devjamescollier/Dual-Channel_Embedded_Power_Supply_Board/Manufacturing/Assembly/BOM.csv

Comment | Designator | Footprint | LCSC Part # | MPN | Quantity
4.7uF | C1,C2,C10,C11 | C_0805_2012Metric | C1779 | CL21A475KAQNNNE | 4
100nF | C3 | C_0603_1608Metric | C14663 | CC0603KRX7R9BB104 | 1
10nF | C4 | C_0402_1005Metric | C15195 | CL05B103KB5NNNC | 1
100nF | C5,C12,C14 | C_0201_0603Metric | C76939 | GRM033R61E104KE14D | 3
47uF | C6,C7 | C_1206_3216Metric | C96123 | CL31A476MPHNNNE | 2
1nF | C8 | C_0402_1005Metric | C1523 | 0402B102K500NT | 1
47pF | C9 | C_0402_1005Metric | C1567 | 0402CG470J500NT | 1
10nF | C13 | C_0201_0603Metric | C85930 | GRM033R71E103KE14D | 1
47uF | C15,C16 | C_1206_3216Metric | C403725 | GRM31CR61E476ME44L | 2
4.7nF | C17 | C_0805_2012Metric | C1744 | 0805B472K500NT | 1
39pF | C18 | C_0402_1005Metric | C1563 | 0402CG390J500NT | 1
12V | D1 | D_SOD-323 | C19077447 | BZT52C12S | 1
5V1 | D2 | D_SOD-123 | C173407 | BZT52C5V1 | 1
B340 | D3,D4 | D_SMC | C110486 | B340-13-F | 2
WHITE | D6 | LED_0603_1608Metric | C2290 | KT-0603W | 1
RED | D7 | LED_0603_1608Metric | C2286 | KT-0603R | 1
YELLOW | D8 | LED_0603_1608Metric | C2287 | KT-0603Y | 1
Conn_01x04_Pin | J1 | JST_GH_SM04B-GHS-TB_1x04-1MP_P1.25mm_Horizontal | C189895 | SM04B-GHS-TB(LF)(SN) | 1
Conn_01x06 | J2 | JST_GH_SM06B-GHS-TB_1x06-1MP_P1.25mm_Horizontal | C133065 | SM06B-GHS-TB(LF)(SN) | 1
Conn_01x01 | J5,J6 | PinHeader_1x01_P2.54mm_Vertical | C492400 | PZ254V-11-01P | 2
Conn_01x02 | J7 | AMASS_XT60-M_1x02_P7.20mm_Vertical | C98733 | XT60-M | 1
6.8uH | L1,L2 | L_Bourns_SRP5030T | C177249 | FXL0530-6R8-M | 2
AONR21357 | Q1 | Vishay_PowerPAK_1212-8_Single | C431196 | AONR21357 | 1
AO3400A | Q4,Q5,Q6 | SOT-23 | C20917 | AO3400A | 3
200k | R1,R12 | R_0603_1608Metric | C25811 | 0603WAF2003T5E | 2
56k | R2,R14 | R_0603_1608Metric | C23206 | 0603WAF5602T5E | 2
0 | R3,R16 | R_0603_1608Metric | C21189 | 0603WAF0000T5E | 2
10k2 | R4 | R_0603_1608Metric | C22772 | 0603WAF1022T5E | 1
3k24 | R5 | R_0603_1608Metric | C22994 | 0603WAF3241T5E | 1
29k4 | R13 | R_0603_1608Metric | C22974 | 0603WAF2942T5E | 1
49k9 | R15 | R_0603_1608Metric | C23184 | 0603WAF4992T5E | 1
10k | R17,R25 | R_0603_1608Metric | C25804 | 0603WAF1002T5E | 2
1k91 | R18 | R_0603_1608Metric | C22853 | 0603WAF1911T5E | 1
4k7 | R19 | R_0603_1608Metric | C23162 | 0603WAF4701T5E | 1
100k | R6,R20,R22,R24 | R_0603_1608Metric | C25803 | 0603WAF1003T5E | 4
1k | R21 | R_0603_1608Metric | C21190 | 0603WAF1001T5E | 1
430 | R23 | R_0603_1608Metric | C23170 | 0603WAF4300T5E | 1
TPS54331DR | U2,U3 | SOIC-8_3.9x4.9mm_P1.27mm | C9865 | TPS54331DR | 2
