devjamescollier/Dual-Channel_Embedded_Power_Supply_Board/Hardware/KiCad_Files/3D_Models/TPS54331.stp

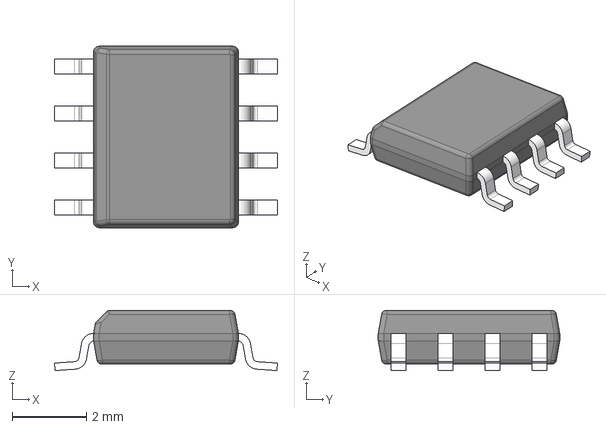
[picture p4: CAD file, 2026-06-27]
Hardware/KiCad_Files/3D_Models/TPS54331.stp
6.02 x 4.90 x 1.63 mm
BODY-SO
LEAD-D0008A x 8
