devjamescollier/Dual-Channel_Embedded_Power_Supply_Board/Docs/Images/Dual-Channel_Embedded_Power_Control_Schematic.pdf

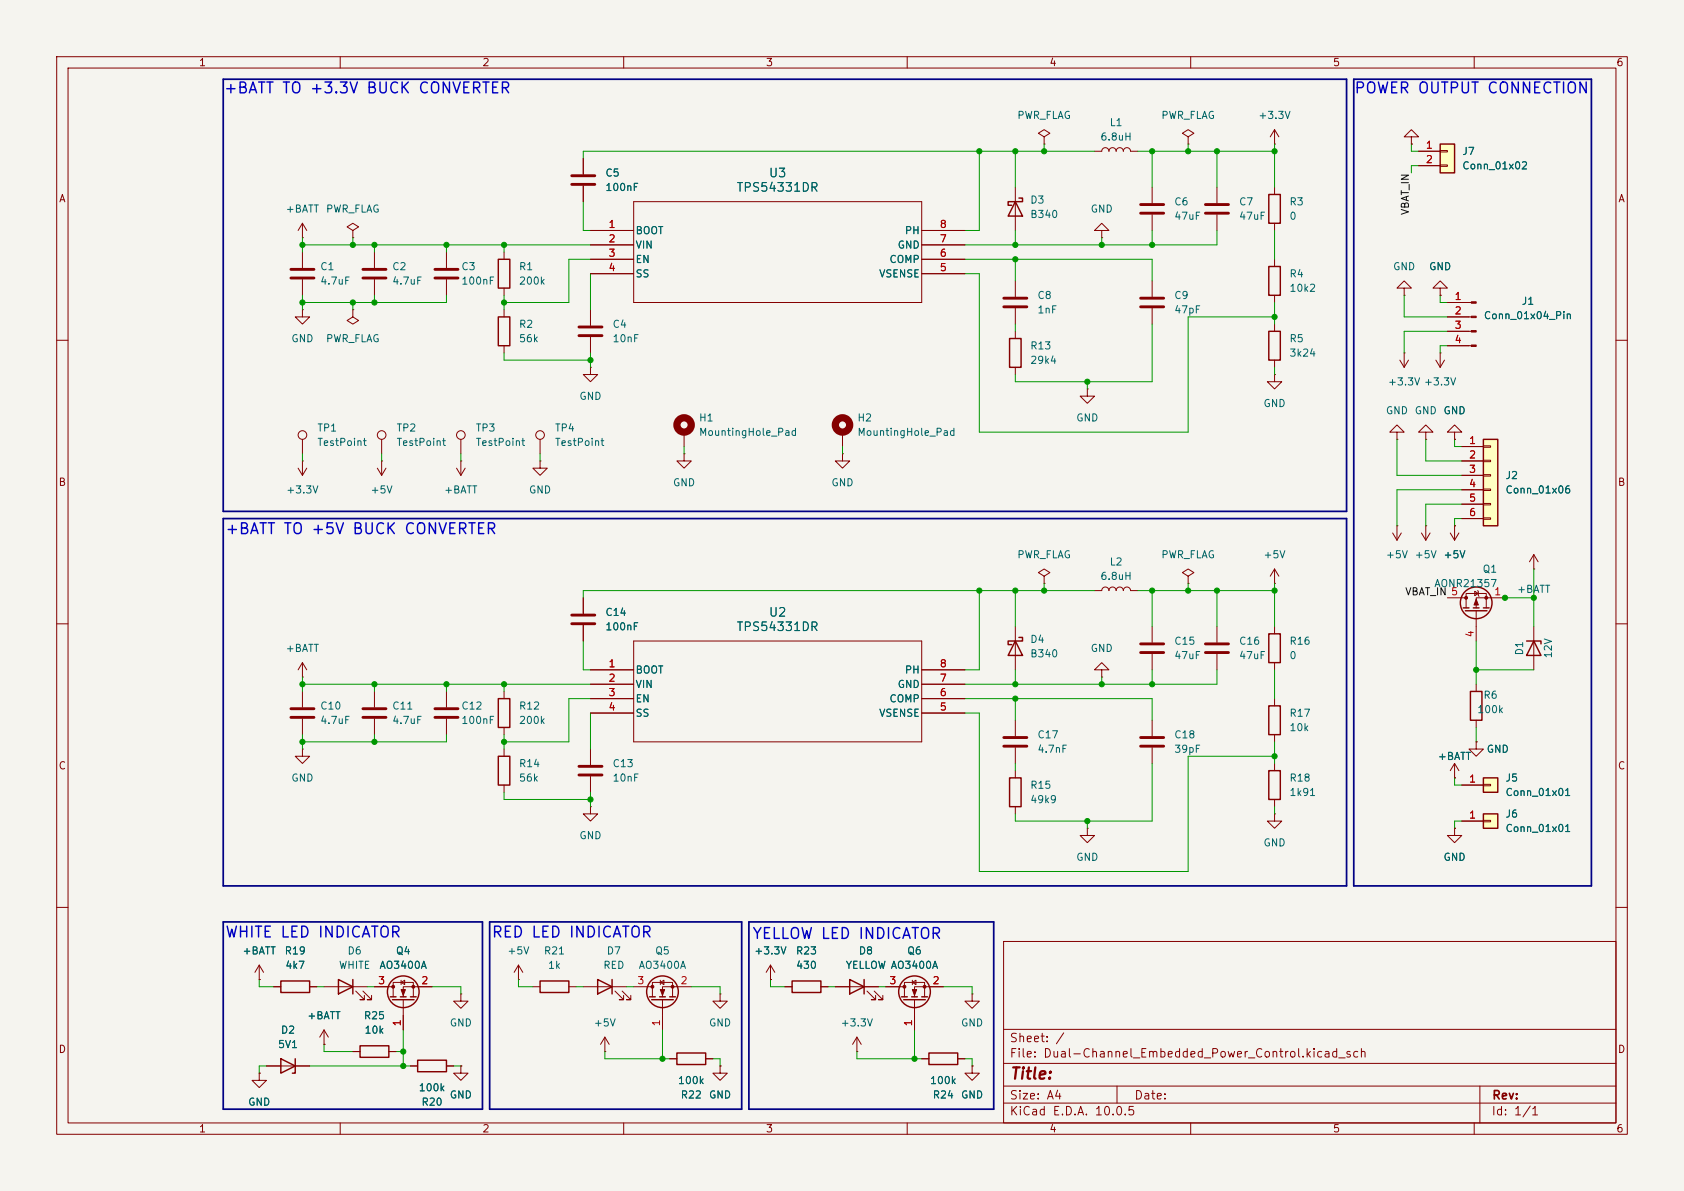
[picture p5: page 1]

+BATT TO +5V BUCK CONVERTER | PWR_FLAG L2 | PWR_FLAG

Size: A4 | Rev:
KiCad E.D.A. 10.0.5 | Id: 1/1
