devjamescollier/Dual-Channel_Embedded_Power_Supply_Board/Hardware/Simulation/reverse_polarity_results.txt

Vbatt   Vout      Vdrop(mV)  Iload(A)  Vgs(V)   Pq1(mW)
4.9  4.85632  43.682  5  -4.85632  218.41
6  5.96759  32.4115  5.00001  -5.96759  162.058
9  8.98095  19.0471  5.00001  -8.98095  95.2359
12  11.9863  13.6962  5.00001  -11.8325  68.4811
24  23.9865  13.5444  5.00014  -11.9464  67.7241
28  27.9865  13.5343  5.00019  -11.9543  67.6738
--- reversed battery ---
-12  Vout=-0.00102397  I_from_batt=1.02399E-09 A
-28  Vout=-0.00105597  I_from_batt=1.05635E-09 A
