devjamescollier/Dual-Channel_Embedded_Power_Supply_Board/Hardware/Simulation/simulation_results.png

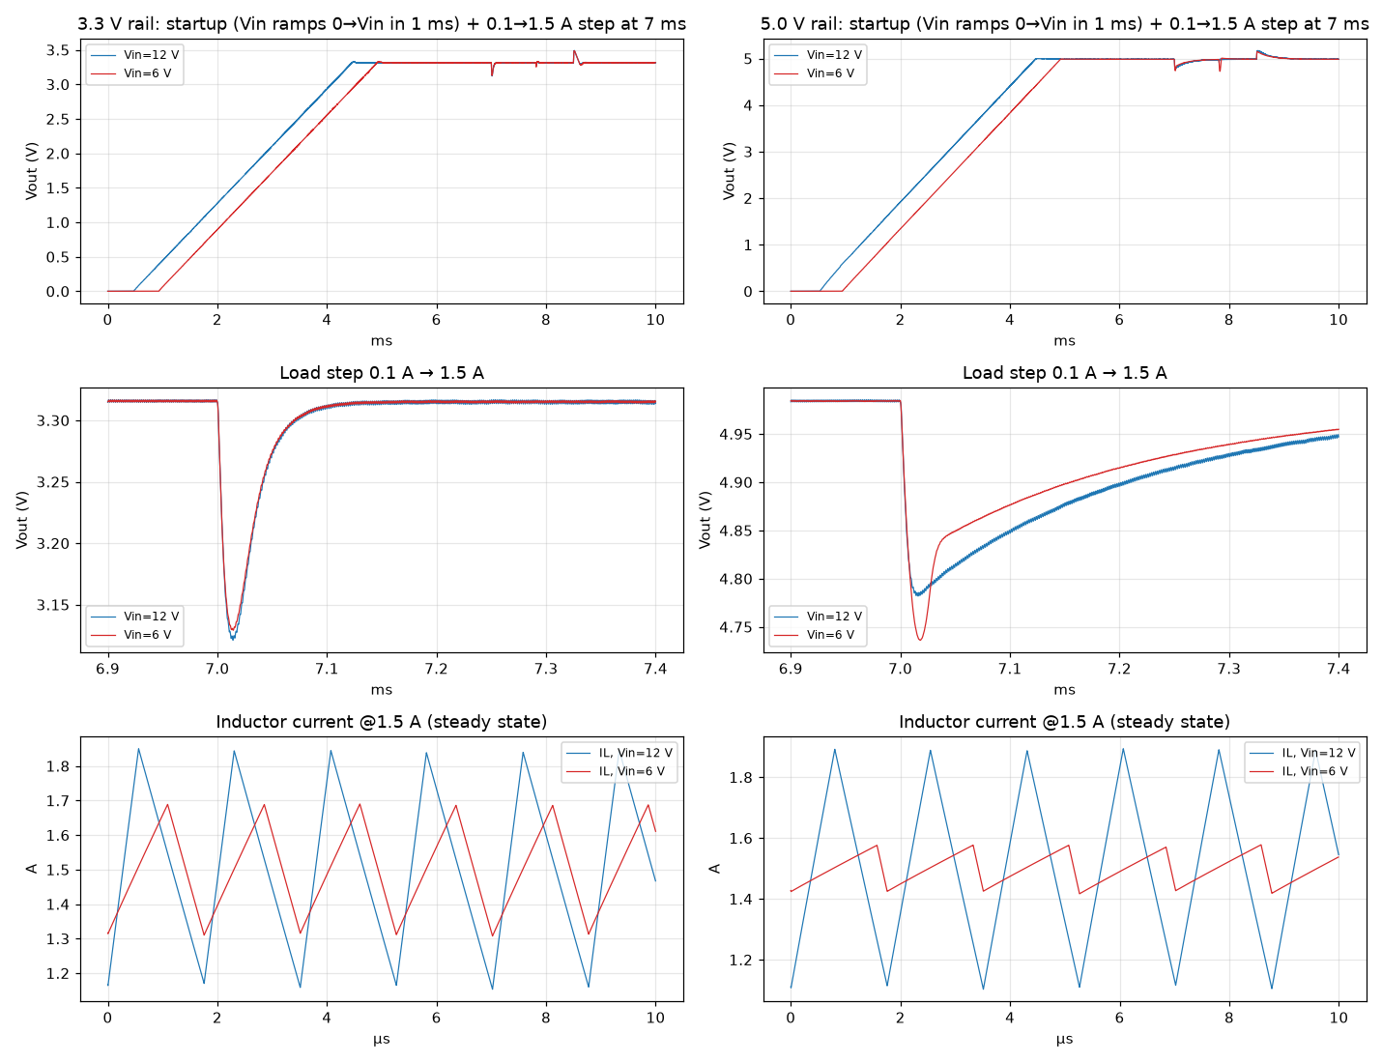
Hardware/Simulation/simulation_results.png
