devjamescollier/Dual-Channel_Embedded_Power_Supply_Board/(commit log)

2026-06-27 Add TPS54331 symbol, footprints, and 3D model
    [TPS54331.stp]
2026-06-29 Add buck converter schematic and project file
    [Dual-Channel_Embedded_Power_Control.kicad_sch]
2026-06-30 Add SPICE models for both output rails
2026-07-07 Add PCB layout and custom design rules
    [Dual-Channel_Embedded_Power_Control.kicad_pcb]
2026-07-08 Add Gerber and drill files
    [Dual-Channel_Embedded_Power_Control-B_Cu.gbl, Dual-Channel_Embedded_Power_Control-B_Mask.gbs, Dual-Channel_Embedded_Power_Control-B_Paste.gbp, Dual-Channel_Embedded_Power_Control-B_Silkscreen.gbo, Dual-Channel_Embedded_Power_Control-Edge_Cuts.gm1, Dual-Channel_Embedded_Power_Control-F_Cu.gtl, Dual-Channel_Embedded_Power_Control-F_Mask.gts, Dual-Channel_Embedded_Power_Control-F_Paste.gtp]
2026-07-09 Add BOM and placement files
    [BOM.csv, positions.csv]
2026-07-10 Add schematic exports
