devjamescollier/Dual-Channel_Embedded_Power_Supply_Board/(notices)

Notices in the files:
README.md:
Hardware License: CERN-OHL-P-2.0
